aman-singh14/Byte-me/hardware/nose_pad.stl

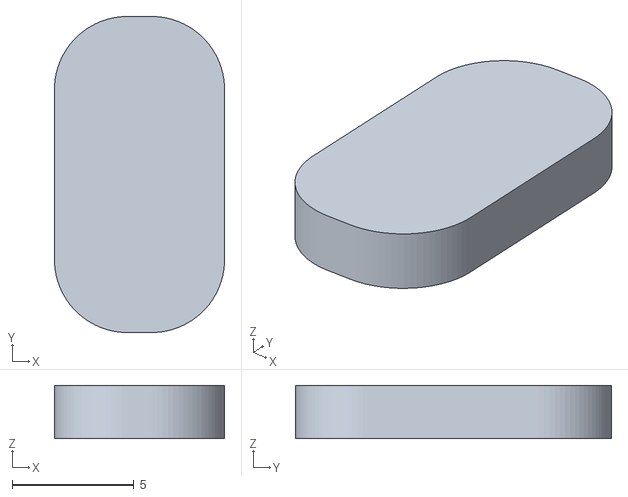
[picture p1: CAD file, 2026-10-24]
hardware/nose_pad.stl
7.00 x 13.0 x 2.20
