aman-singh14/Byte-me/hardware/fpga_retainer.stl

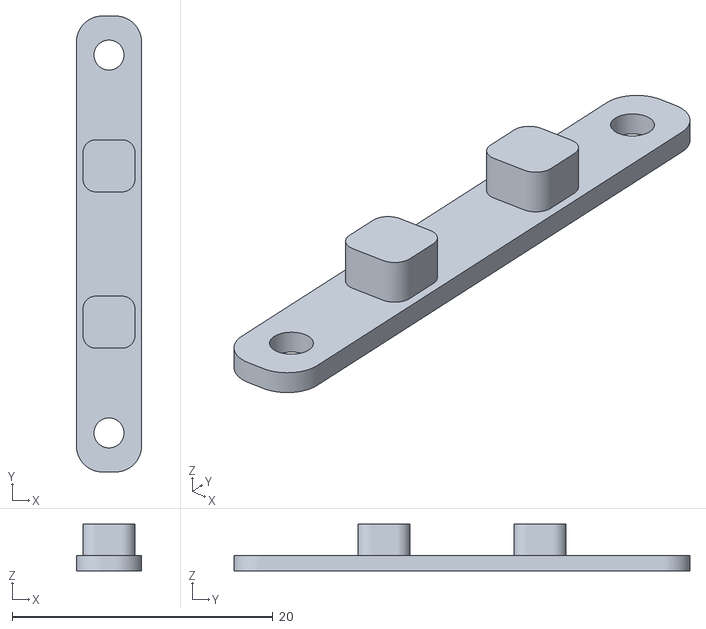
[picture p2: CAD file, 2026-10-24]
hardware/fpga_retainer.stl
5.00 x 35.0 x 3.60
