aman-singh14/Byte-me/hardware/back_box_lower.stl

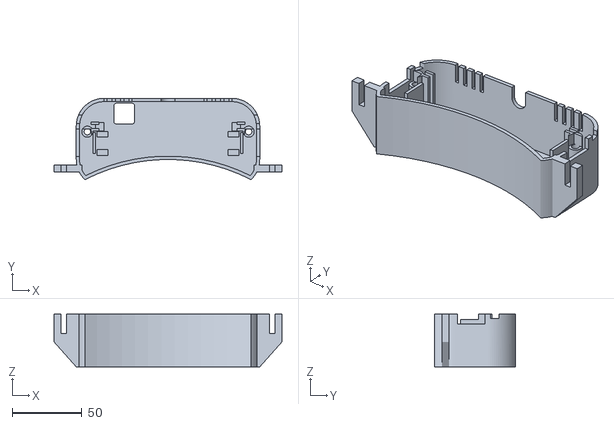
[picture p3: CAD file, 2026-10-24]
hardware/back_box_lower.stl
164.0 x 58.5 x 38.0
