aman-singh14/Byte-me/hardware/eye_cam_sleeve_left.stl

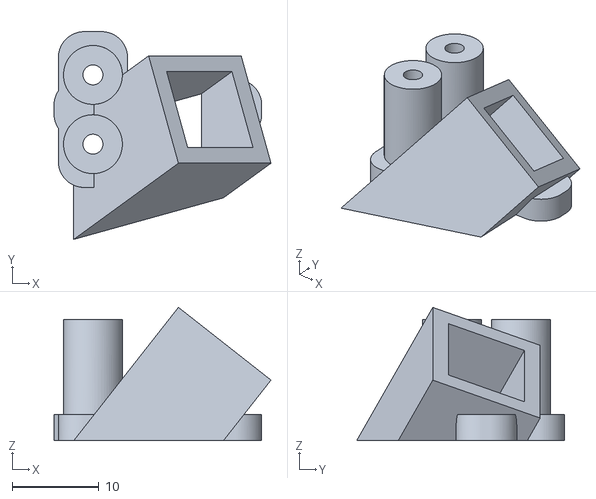
[picture p4: CAD file, 2026-10-24]
hardware/eye_cam_sleeve_left.stl
25.1 x 24.0 x 15.4
