aman-singh14/Byte-me/hardware/rear_camera_retainer.stl

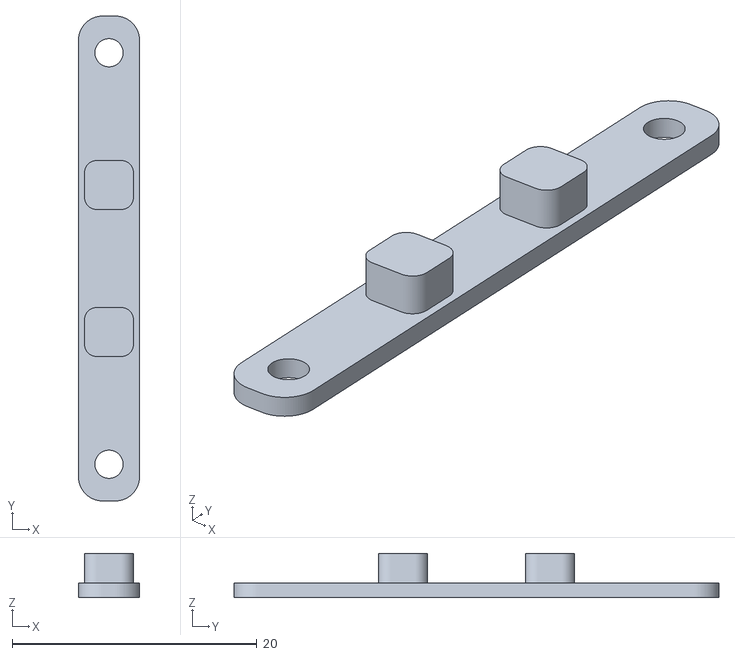
[picture p5: CAD file, 2026-10-24]
hardware/rear_camera_retainer.stl
5.00 x 39.6 x 3.60
