aman-singh14/Byte-me/hardware/back_box_upper.stl

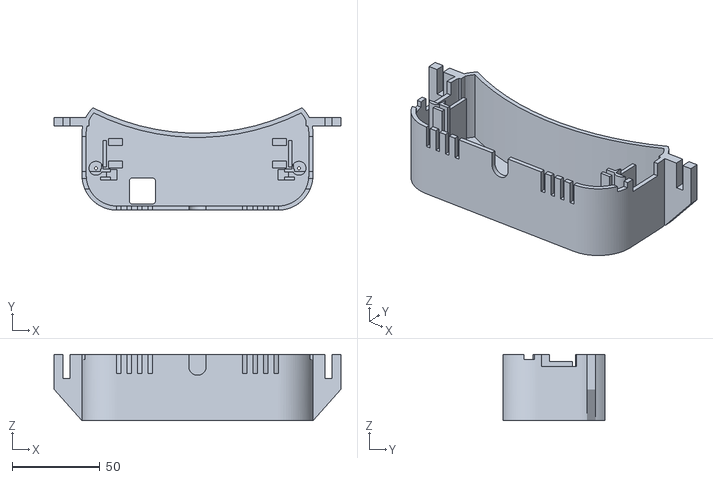
[picture p6: CAD file, 2026-10-24]
hardware/back_box_upper.stl
164.0 x 58.5 x 38.0
