aman-singh14/Byte-me/hardware/electronics_cassette.stl

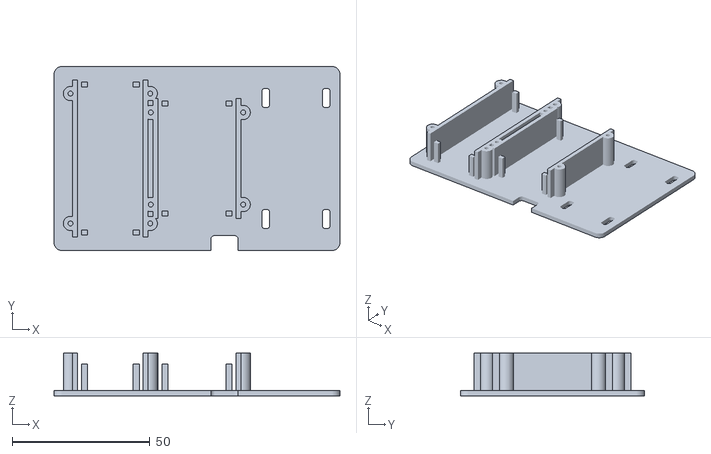
[picture p7: CAD file, 2026-10-24]
hardware/electronics_cassette.stl
104.0 x 67.0 x 15.5
