aman-singh14/Byte-me/hardware/temple_arm.stl

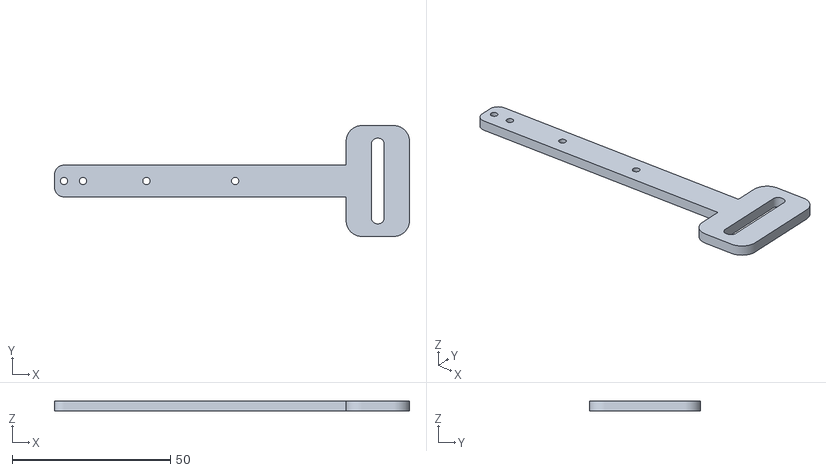
[picture p8: CAD file, 2026-10-24]
hardware/temple_arm.stl
112.0 x 35.0 x 3.20
