aman-singh14/Byte-me/hardware/camera_retainer.stl

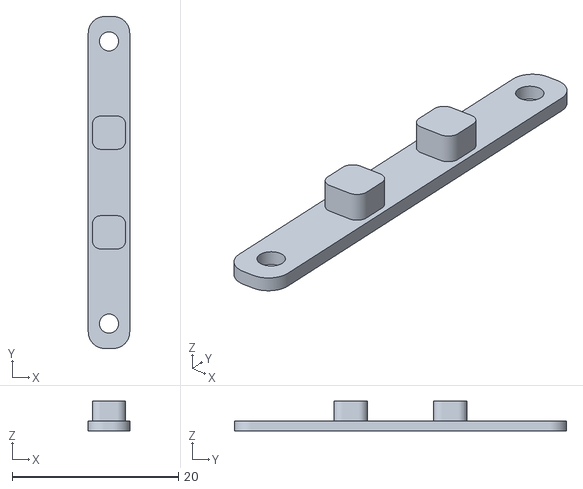
[picture p9: CAD file, 2026-10-24]
hardware/camera_retainer.stl
5.00 x 40.0 x 3.60
