aman-singh14/Byte-me/hardware/frame_front.stl

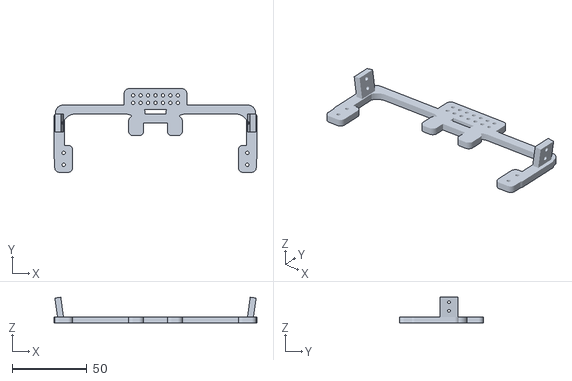
[picture p10: CAD file, 2026-10-24]
hardware/frame_front.stl
136.0 x 56.0 x 17.1
