aman-singh14/Byte-me/hardware/arm_cam_tray.stl

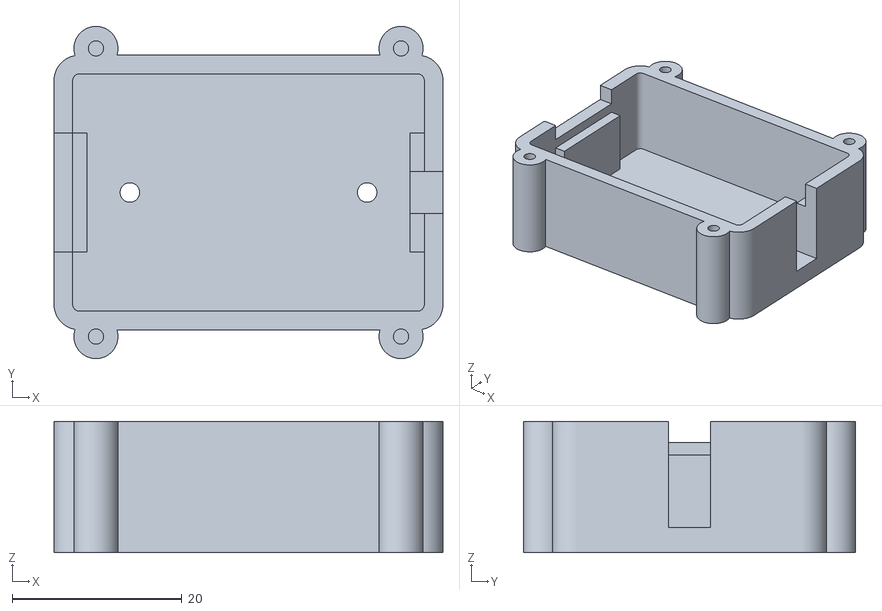
[picture p11: CAD file, 2026-10-24]
hardware/arm_cam_tray.stl
45.9 x 39.2 x 15.5
