aman-singh14/Byte-me/(list of files, cad)

Other CAD files:
hardware/eye_cam_sleeve.stl
hardware/scene_cam_mount.stl
