aman-singh14/Byte-me/firmware/esp32cam/secrets.example.h

// Copy to secrets.h (gitignored) and fill in. 2.4 GHz networks only.
// iPhone hotspot: Settings > Personal Hotspot > Maximize Compatibility ON.
#pragma once
#define WIFI_SSID "your-hotspot-name"
#define WIFI_PASSWORD "your-hotspot-password"
