aman-singh14/Byte-me/(commit log)

2026-10-24 Mega Glasses: mobile app, backend, firmware
    - mobile-app/: Flutter companion app
    - lgmd.py, test_lgmd.py, mock_glasses.py: LGMD reference model, tests, fake glasses
    - backend/: camera streams, eye tracking, distance, rear alerts, SQLite, FastAPI, web dashboard
    - firmware/esp32cam: AI-Thinker ESP32-CAM sketch; firmware/lgmd_c: C port of LGMD
    - docs/: FaceTime/OBS setup, iOS Screen Time note
2026-10-24 Ignore .env (Muse API key) and pin ultralytics for YOLO
2026-10-24 Split product config (ESP32 streams + FPGA rear) from dev stand-ins (--dev)
    - config.yaml: EYE/FRONT are ESP32-CAM MJPEG URLs, no fallbacks, close-up
    pupil eye tracking, screen-width distance (per device), rear.mode: fpga
    - config.dev.yaml (--dev): webcam + face mesh, face-width distance,
    synthetic software LGMD; still images and sample:<name> sources
    - A dead stream now marks the camera offline (dashboard banner, live
    values cleared) instead of showing stale numbers; retries forever
    - Face mesh and face-width distance labelled DEV ONLY
2026-10-24 Docs: product runs on ESP32 + FPGA cameras; add Dev mode (no hardware) section
2026-10-24 Add fpga/ (FPGA teammate's space) and the rear event protocol contract
    - docs/rear_event_protocol.md: framing (sync, version, type, event id,
    seq, len, payload, CRC16-CCITT-FALSE), EVENT/FRAME_CHUNK/END/HEARTBEAT
    byte tables, latency rule (warn on EVENT before the clip), serial / UDP
    / HTTP transports, throughput table, hex examples
    - backend/rear/protocol.py: reference encoder/decoder, resyncing stream
    parser, clip reassembly with drop and CRC handling; 17 tests
    - fpga/: README (ownership, connection, lgmd.py as bit-exact reference)
    and empty rtl/ constraints/ sim/ bridge/
2026-10-24 Close-up pupil tracking as the eye method, with a synthetic close-up eye
    - CloseupEye: adaptive dark-pupil threshold anchored to the learned pupil
    darkness (so the iris is never taken for a covered pupil), search window
    around the last pupil, lash removal by opening, glint holes filled and
    edge notches removed by the convex hull, round/dark/size scoring.
    Openness = visible pupil area / full pupil area
    - Blinks counted as 2-7 closed frames (product); dev webcam keeps seconds
    - No pupil right after seeing one = closed lid; no pupil for > 2 s = eye
    not in view (not a closure, no calibration from it)
    - backend/synth_eye.py + 'synthetic-eye' source: off-axis close-up eye with
    glint, l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
2026-10-24 Add gaze (left/center/right) with spoken calibration, and one shared voice
    - backend/gaze.py: nearest calibrated centroid + hysteresis + majority
    over 0.5 s; 3 s per step calibration (settle time and blinks skipped),
    stored per user; regions map onto the FRONT frame with ~15% overlap;
    crop helper for 'what am I looking at?'
    - API: GET /gaze, POST /gaze/calibrate, POST /gaze/calibrate/cancel,
    PUT /gaze/regions; live state carries gaze + calibration progress
    - backend/speech.py: one queue for laptop TTS, browser 'speak' events and
    a future ESP32 I2S speaker; urgent messages (rear danger) interrupt
    - 13 tests incl. a mirrored mount and >=95% accuracy on the synthetic eye
2026-10-24 Add 'what am I looking at?': gaze crop -> local YOLO (spoken now) -> Muse
    - backend/vision.py: shared YOLOv8n detector (~25 ms), positions relative
    to the wearer, rough distances from known object sizes, spoken-friendly
    quick answers
    - backend/muse_client.py: Muse Spark via Meta's OpenAI-compatible API;
    key from MUSE_API_KEY/.env; frames downscaled to 512 px JPEG; every
    call logged with tokens and cost; hard lifetime cap ($10), daily cap,
    6 calls/min; privacy system prompt (never identify people)
    - backend/assist.py: region from override / question words / gaze, crop
    the FRONT frame, speak the local answer before Muse is called, then
    speak Muse's answer; falls back to the local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
2026-10-24 Rear FPGA path: receive events, warn instantly, classify the clip, follow up
    - backend/rear/service.py: UDP (:4300), USB-serial and HTTP receivers ->
    stream parser -> clip assembler. EVENT -> urgent generic warning before
    any frame arrives (side named only when LGMD clearly favours one third);
    END/timeout -> classify on a worker thread, save the clip, speak the
    result, store it as an alert; optional one-frame Muse description
    - backend/rear/classifier.py: YOLO on the newest frames, time to contact
    from box growth, wearer side (mirrored); danger / not approaching /
    unknown looming object / nothing (leaves, shadows)
    - Lost GRAY8 chunks are refilled from the previous frame so a loss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
2026-10-24 Dashboard: ask the glasses, live gaze + calibration, rear results, FaceTime card
    - 'What am I looking at?' button, left/ahead/right/everything, push-to-talk
    (browser speech recognition on localhost/HTTPS) and a text box; quick
    local answer then Muse answer, live over the WebSocket; Muse spend
    - Gaze L/C/R indicator with spoken, counted-down calibration prompts
    - 'Speak answers on this device' (browser TTS; on by default off-laptop),
    urgent rear warnings interrupt
    - Rear list shows what each FPGA event was (danger / unknown / ignored),
    side and time to contact; FPGA link status
    - Prominent 'Switch FaceTime to glasses view' (Mac only, iPhone: screen
    share); DEV MODE badge when runnin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
2026-10-24 schematic upload
2026-10-24 README: architecture (ESP32 streams / FPGA / laptop / Muse), dev mode, full API
    Root README keeps the LGMD docs and gains a pointer to the system docs.
2026-10-24 Add the alert engine: tracking, time to contact, alert levels
    Pure Dart, no UI. Tracks rear-camera boxes across frames and estimates
    time to contact from box growth (slope of ln height over the last second),
    then picks the one alert the wearer should feel:
    - gentle / urgent thresholds per class, scaled by sensitivity and night mode
    - confirmed for 0.3 s before it buzzes, held 1 s so it doesn't flicker
    - frozen while the head turns; a glance back toward it silences it
    - reflex fires (Cam B) are urgent at once and can be named later
    - "possibly following" after 3 minutes of presence (never identity)
    - people only alert when straight behind; partial (cut-off) people and
    tiny boxes are not me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
2026-10-24 Add the rear camera stream and YOLO detection
    - MJPEG client for Cam A (newest frame only, in memory, auto-reconnect)
    - YOLO26n through ultralytics_yolo, filtered to the 8 alert classes;
    320 px exports for iOS (Core ML) and Android (LiteRT) in assets/models,
    regenerated by tool/export_yolo.py
    - detection loop: one frame at a time, always the newest
    - RearView component: mirrored like a rear-view mirror, every box labelled
    with the wearer's side
    Also adds flutter_tts and shared_preferences, used by the alerts UI next
    (their CocoaPods setup is in the iOS project changes).
2026-10-24 Show alerts in the app: banner, side indicator, voice, event log
    - AlertService feeds the engine from the glasses (sens, fire) and the rear
    camera, sends alert / stop to the frame, keeps the event log
    - alert banner pinned on every tab (dismiss works like glancing back);
    side indicator and live rear view with boxes on Aware
    - one app-wide announcer: phone haptics matching the glasses, a spoken
    one-word label (on-device text-to-speech), or the full sentence through
    the screen reader when it is on
    - "possibly following" card; event log on Aware and the latest entry on
    Today, kept on the phone for 7 days and never shared
    - debug builds label each box with its time to contact or why it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
2026-10-24 Name reflex fires from Cam B's video; docs and mock
    When Cam B's reflex (the FPGA's locust detector) fires, the alert goes out
    at once; then YOLO runs on Cam B's newest frames and the biggest object on
    the fire's side (or straight behind) names it. The voice waits up to
    0.3 s for the name, so the wearer hears "Car" rather than "Behind" then
    "Car". Repeated fires on one side are named once.
    This assumes Cam B serves MJPEG like Cam A and says hello as "camB"; the
    FPGA team's rear event protocol (docs/rear_event_protocol.md) sends a
    binary EVENT + clip instead, so the transport here is expected to change.
    Also: Settings shows the reflex camera, the README documents Phase 1
    (rear view, alert e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
2026-10-24 Keep "someone behind you" current: update it each minute
    The engine reported a possible follower once, at 3 minutes, so the notice
    and the log entry froze there. It now sends a quiet update for each further
    minute the same presence stays (matched across short gaps), which refreshes
    the notice and the one log entry without speaking again. A dismissed notice
    stays dismissed.
2026-10-24 Add tokenized helper rooms and newest-frame video relay
2026-10-24 Add wearer helper calls, camera upload, and haptic guidance
2026-10-24 add eye, close-up, rings, gaze and look features, merged with aman's app
    - backend: close-up pupil tracking, partial blinks, low-blink warning, left/center/right gaze
    - backend: phone/laptop/book close-up sessions, heads-up breaks, outside detection, rings and points
    - backend: "what am i looking at" (yolo, then muse), esp32 camera discovery, new eyes/rings/closeup endpoints
    - esp32 sketch: 320x240 streams, on-demand still, exposure sensor, hello broadcast
    - app: eyes, rings and "what am i looking at" screens, laptop address setting; rings feed aman's quests
    - remove extra readmes; tests for all of the above
2026-10-25 fpga code for back camera
2026-10-25 add eye open/squint/closed calibration, pupil shape gaze, and esp32 code for eye, front and back cameras
2026-10-25 set camera ports, move backend to 8001, restore original back camera code
2026-10-25 stream eye and front cameras over udp on port 81 with mjpeg fallback, grey eye camera, sharper front stills for muse and yolo
